fwacer/esp8266-event-notifier/Photos/6_interior.jpg

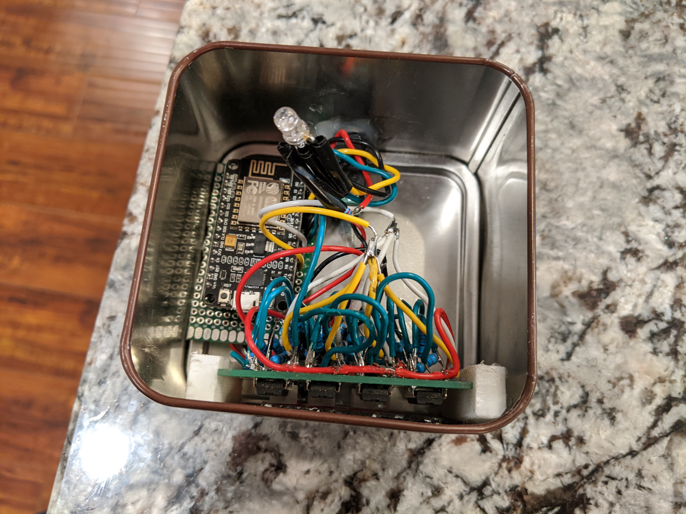
Photos/6_interior.jpg
