fwacer/esp8266-event-notifier/Photos/7_startup.jpg

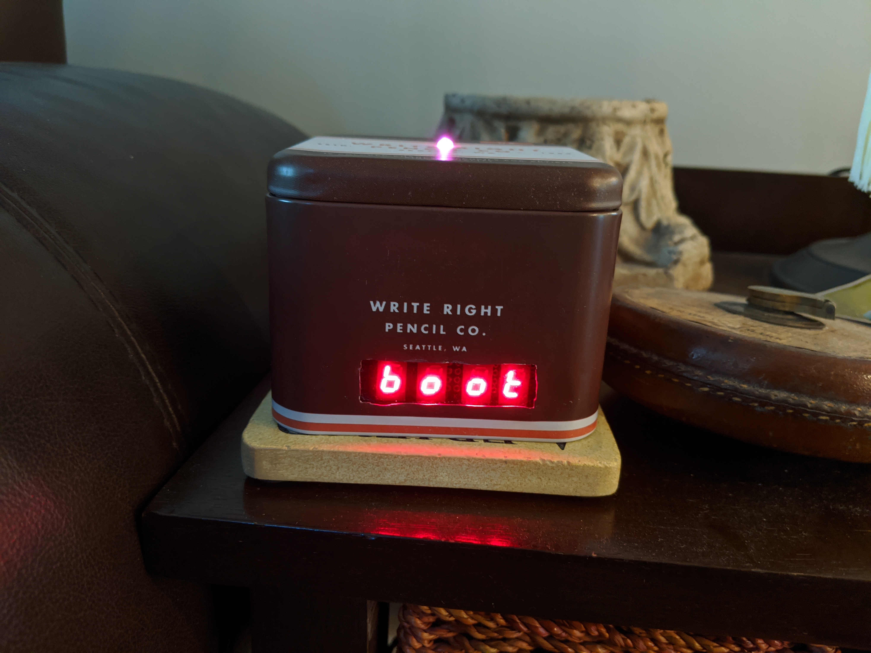
Photos/7_startup.jpg
