fwacer/esp8266-event-notifier/Photos/8_sleep.jpg

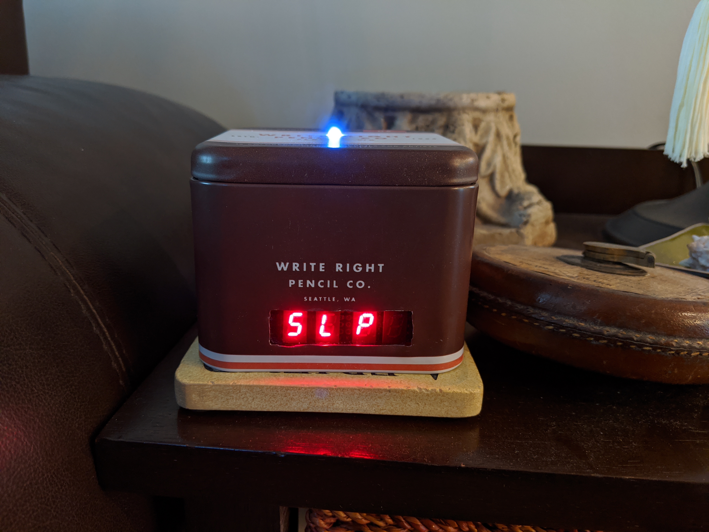
Photos/8_sleep.jpg
