fwacer/esp8266-event-notifier/Photos/9_candid.jpg

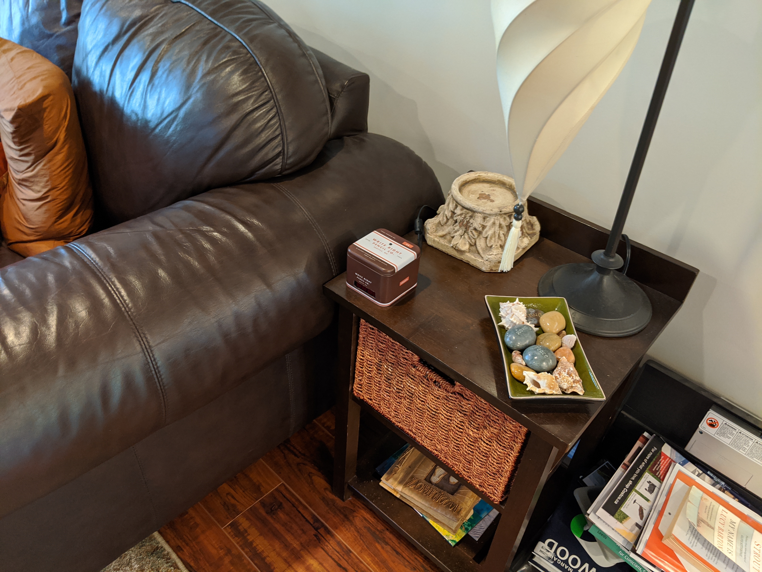
Photos/9_candid.jpg
