fwacer/esp8266-event-notifier/Extra files/esp8266_event_notifier_schematic.pdf

# GND

26

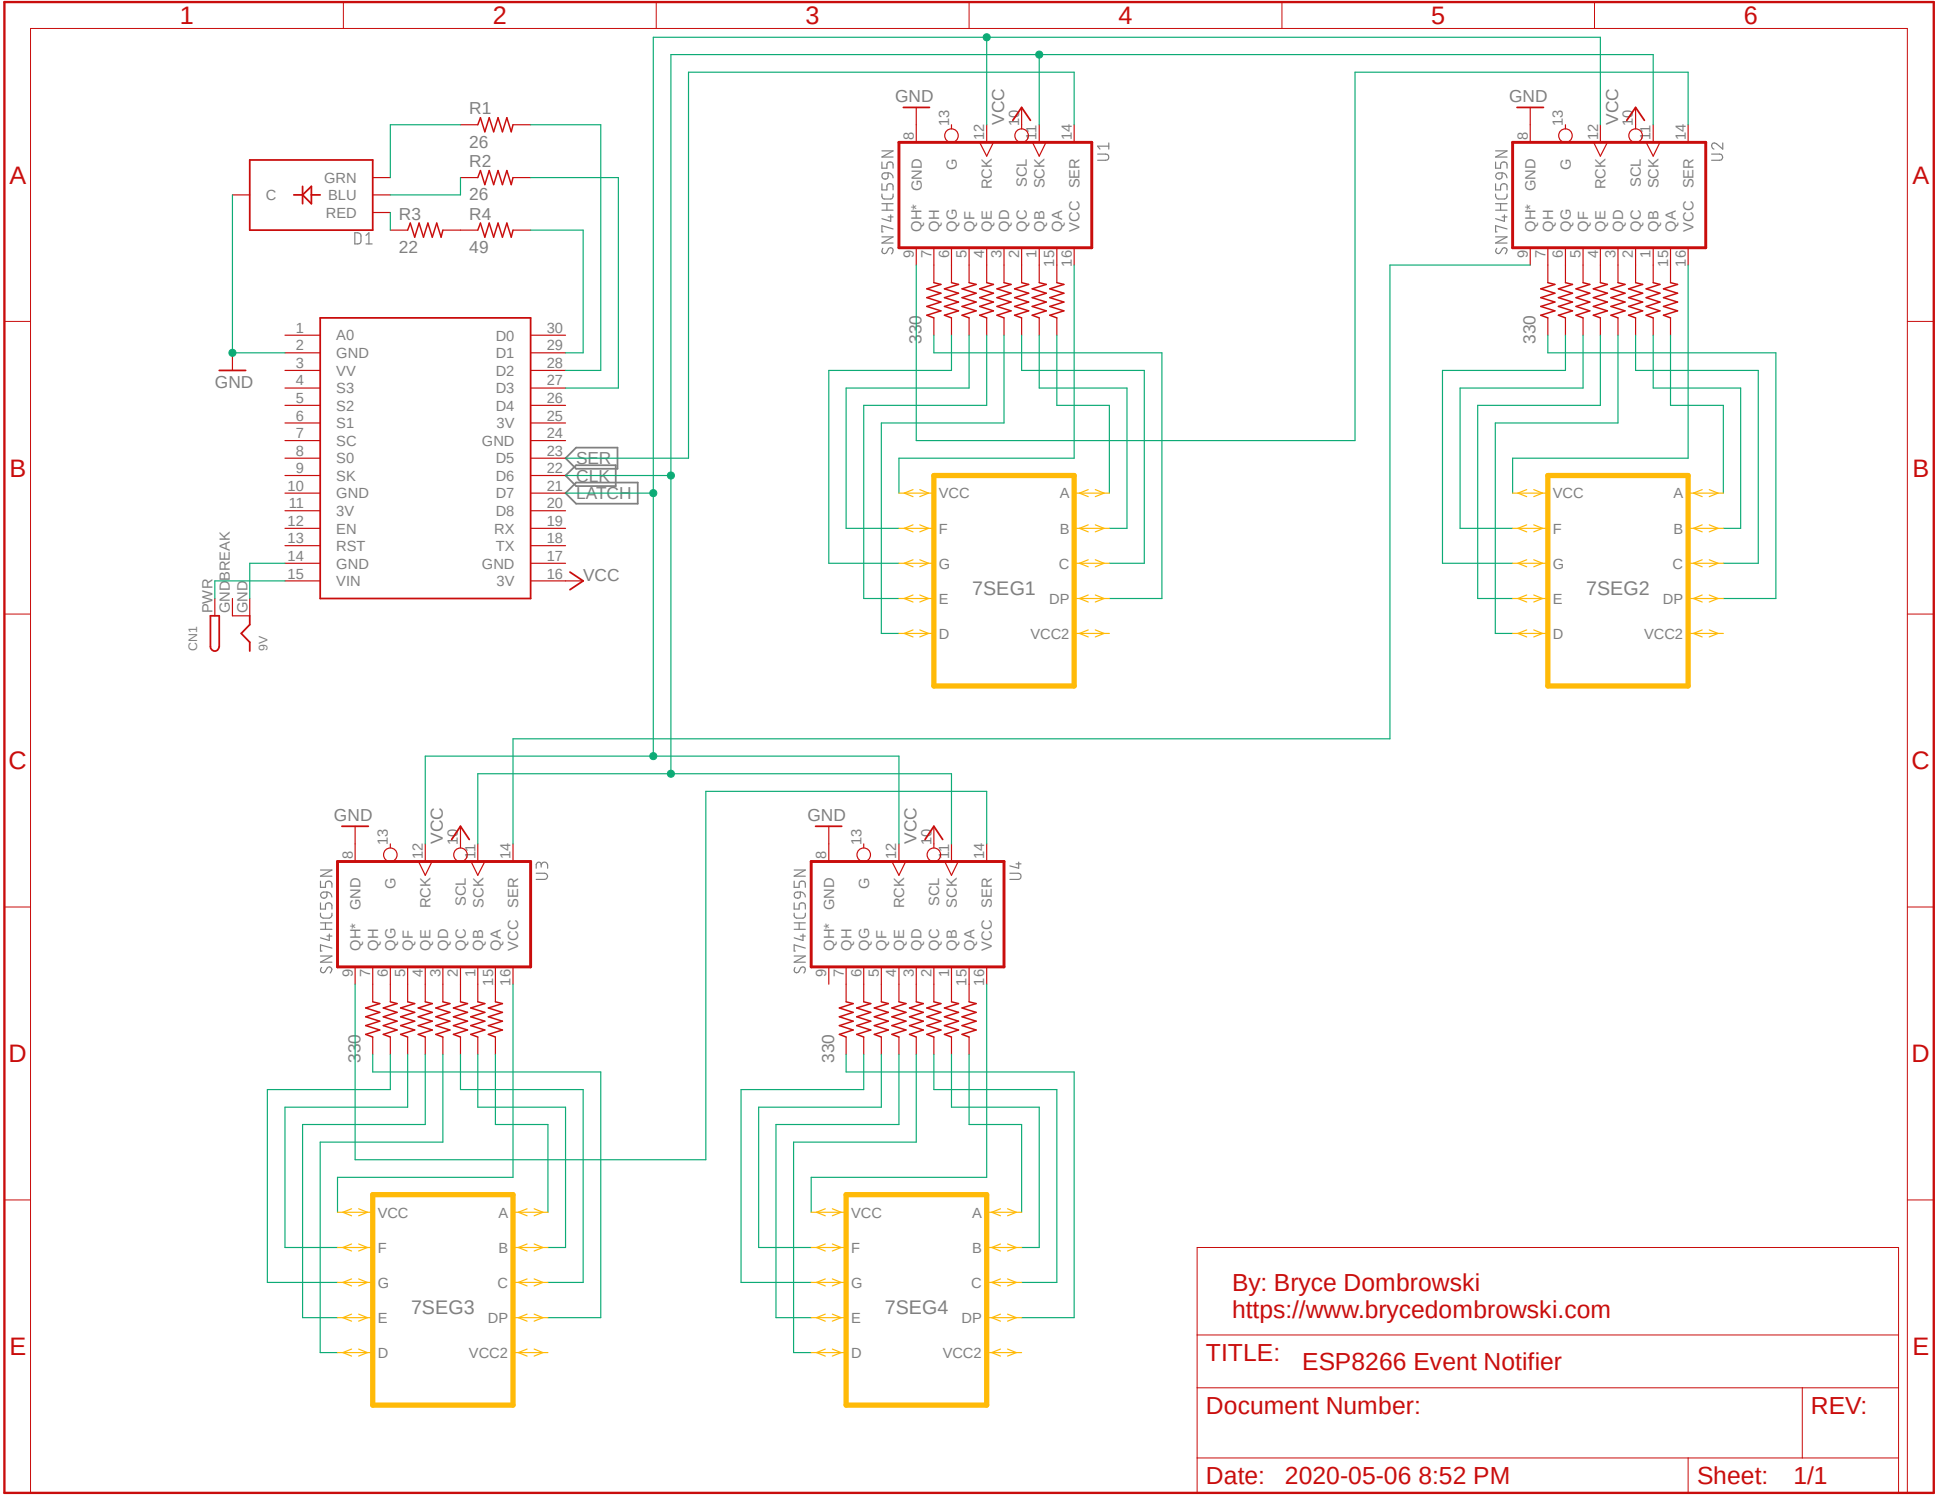
[picture p7: page 1]

7 SCL 10 SCK 11 RCK 12 G 13 SER 14 QA 15 QH* 9 GND

8 VCC 16 PWR GNDBREAK GND CN1

By: Bryce Dombrowski
https://www.brycedombrowski.com
TITLE:

Document Number: | REV:

Date: 2020-05-06 8:52 PM | Sheet: 1/1
