fwacer/esp8266-event-notifier/esp8266-event-notifier.sch

## EAGLE design esp8266-event-notifier.sch (2020-04-30)

Schematic: esp8266-event-notifier.sch

Parts:
CN1: 9V; DCJACK_2MM_PTH
D1: XZM2CRKM2DGFBB45SCCB; PLCC4SMDLED
R1, R2: 26; R0805
R3: 22; R0805
R4: 49; R0805
R5, R6, R7, R8, R9, R10, R11, R12, R13, R14, R15, R16, R17, R18, R19, R20, R21, R22, R23, R24, R25, R26, R27, R28, R29, R30, R31, R32, R33, R34, R35, R36: 330; R0805
U1, U2, U3, U4: SN74HC595N; DIP16
U$1: NODEMCU
