fwacer/esp8266-event-notifier/Photos/3_soldering.jpg

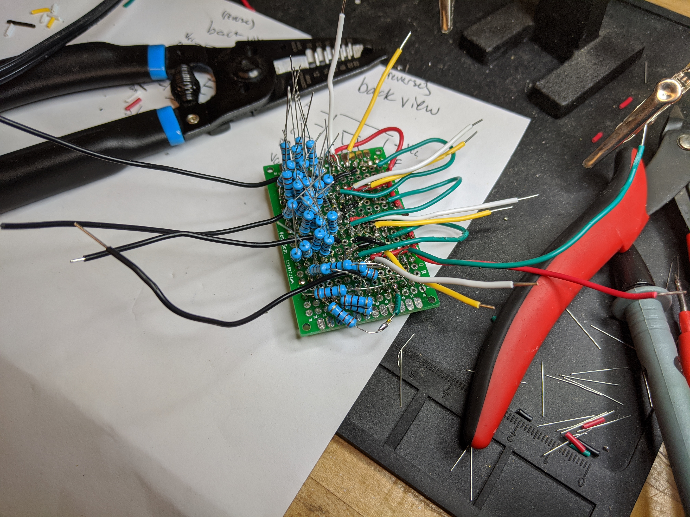
Photos/3_soldering.jpg
