fwacer/esp8266-event-notifier/(commit log)

2020-04-27 Adding time display module
    [esp8266-event-notifier.sch]
2020-04-29 WORKING!!!
    seven segment display - working
    led - working
    calendar event detection - working
    To Do: set it to check for events earlier if it detects one is coming soon
    [esp8266-event-notifier.sch]
2020-05-07 Added schematic pdf
    Also removed library files, the user should copy them directly from the source
    [esp8266_event_notifier_schematic.sch]
2020-05-07 Re-organized and added photos
    [esp8266_event_notifier_schematic.sch]
2020-05-14 Update README.md
    Fixed SensorsIOT's name
2020-06-06 Remove old defines
    Missed that these are no longer required from my changes in the last commit.
    [esp8266-event-notifier.ino]
