fwacer/esp8266-event-notifier/(notices)

Notices in the files:
parts and their libraries:
SparkFun-IC-Logic: Licensing: Creative Commons ShareAlike 4.0 International - https://creativecommons.org/licenses/by-sa/4.0
