fwacer/esp8266-event-notifier/Photos/5_clock_test.jpg

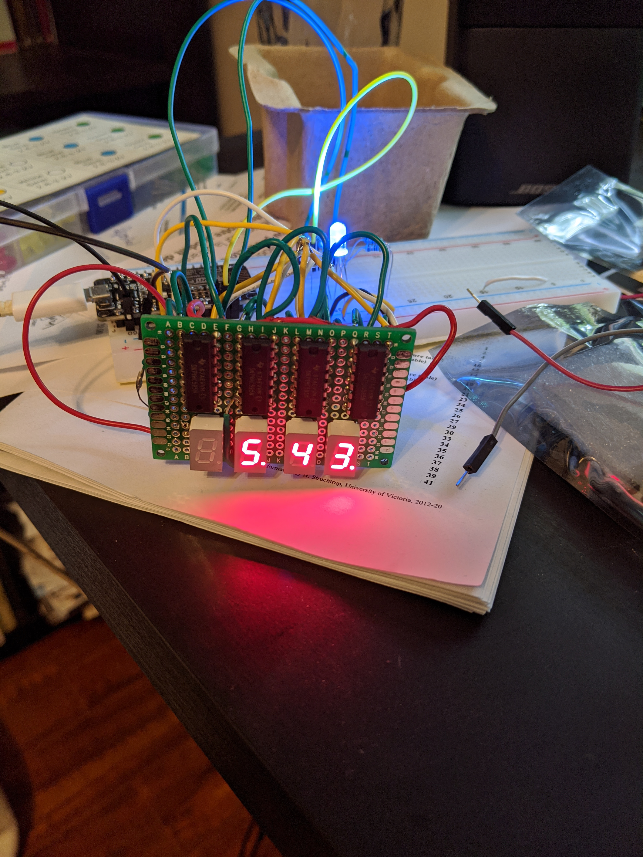
Photos/5_clock_test.jpg
