fwacer/esp8266-event-notifier/Photos/4_soldering_finished.jpg

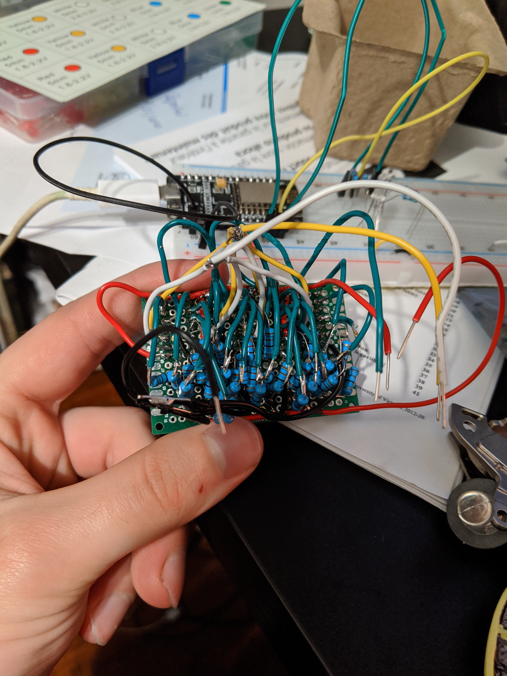
Photos/4_soldering_finished.jpg
